edward62740/Zigbee-Tracker/README.md

# Zigbee Tracker

This is a simple RSSI-based tracking and sensor system.
