edward62740/Zigbee-Tracker/PCB Files/CC2530 Arduino Shield PCB/CC2530 Arduino Shield.png

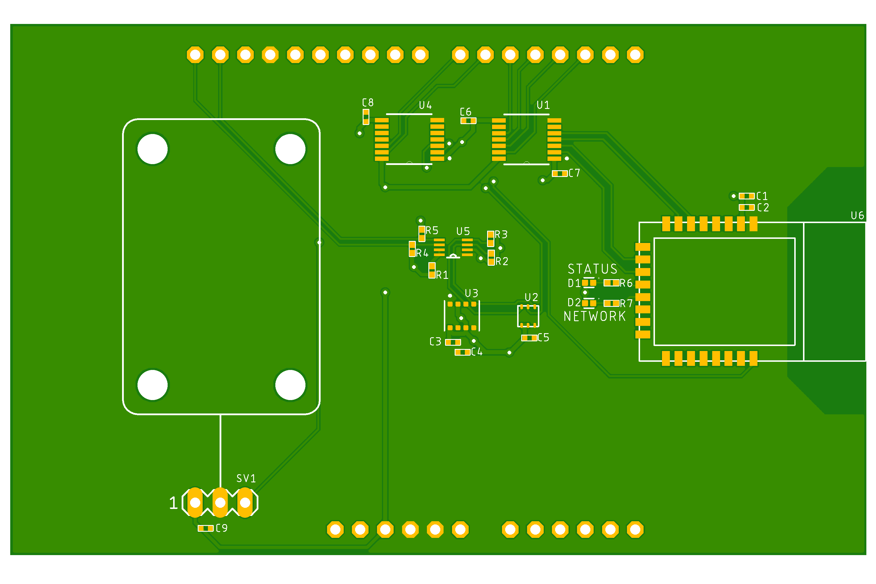
PCB Files/CC2530 Arduino Shield PCB/CC2530 Arduino Shield.png
