edward62740/Zigbee-Tracker/PCB Files/Zigbee Tracker v2.0 Debugger PCB/Zigbee Tracker v2 Debugger.brd

## EAGLE design PCB Files/Zigbee Tracker v2.0 Debugger PCB/Zigbee Tracker v2 Debugger.brd (2020-03-26)

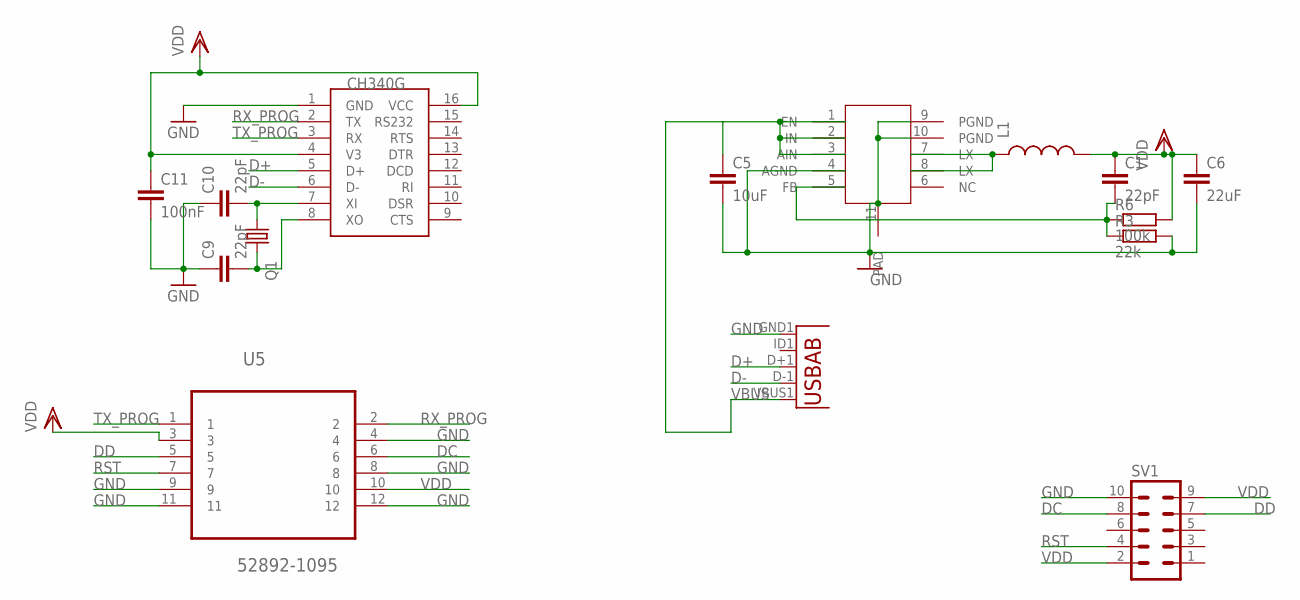
[picture p6: schematic Zigbee Tracker v2 Debugger.sch]

Parts:
C1, C9, C10: 22pF; C0402
C5: 10uF; C0402
C6: 22uF; C0402
C11: 100nF; C0402
L1: INDUCTOR; L0603
Q1: KX-7; 3.2X2.5_KX-7
R3: 22k; R0402
R6: 100k; R0402
SV1: MA05-2
U1: USB""; USB-MICRO-SMD
U5: 52892-1095; MOLEX_52892-1095
U$1: XM5152; SON50P300X300X80-11T170X240
U$2: CH340G; SOIC16

Connections:
D+: U1.D+1 (D+), U$2.5 (D+)
D-: U1.D-1 (D-), U$2.6 (D-)
DC: SV1.8, U5.6
DD: SV1.7, U5.5
GND: C5.2, C6.2, C9.1, C10.1, C11.2, R3.2, SV1.10, U1.GND1 (GND), U5.4, U5.8, U5.9, U5.11, U5.12, U$1.4 (AGND), U$1.9 (PGND), U$1.10 (PGND), U$1.11 (PAD), U$2.1 (GND)
unnamed: L1.1, U$1.7 (LX), U$1.8 (LX)
unnamed: C9.2, Q1.3 (2), U$2.8 (XO)
unnamed: C10.2, Q1.1, U$2.7 (XI)
unnamed: C1.2, R3.1, R6.1, U$1.5 (FB)
RST: SV1.4, U5.7
RX_PROG: U5.2, U$2.2 (TX)
TX_PROG: U5.1, U$2.3 (RX)
VBUS: C5.1, U1.VBUS1 (VBUS), U$1.1 (EN), U$1.2 (IN), U$1.3 (AIN)
VDD: C1.1, C6.1, C11.1, L1.2, R6.2, SV1.2, SV1.9, U5.3, U5.10, U$2.4 (V3), U$2.16 (VCC)

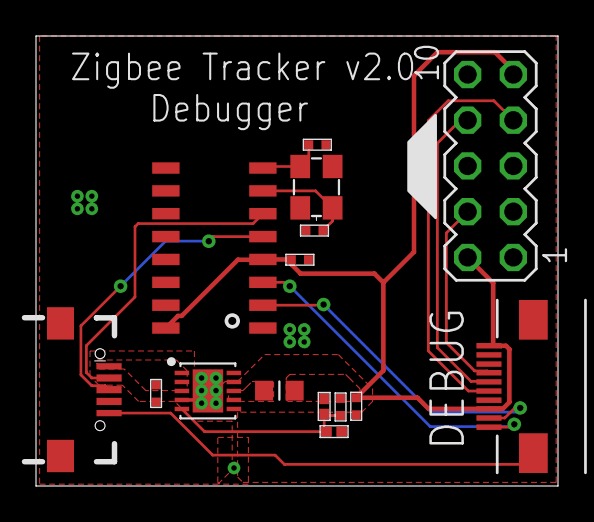
[picture p7: board Zigbee Tracker v2 Debugger.brd from above]

Board: 2 copper layers, 29.0 x 25.0 mm, 15 parts (0 on the bottom side), 14 nets.
