edward62740/Zigbee-Tracker/PCB Files/CC2530 Arduino Shield PCB/CC2530 Arduino Shield.brd

## EAGLE design PCB Files/CC2530 Arduino Shield PCB/CC2530 Arduino Shield.brd (2020-03-26)

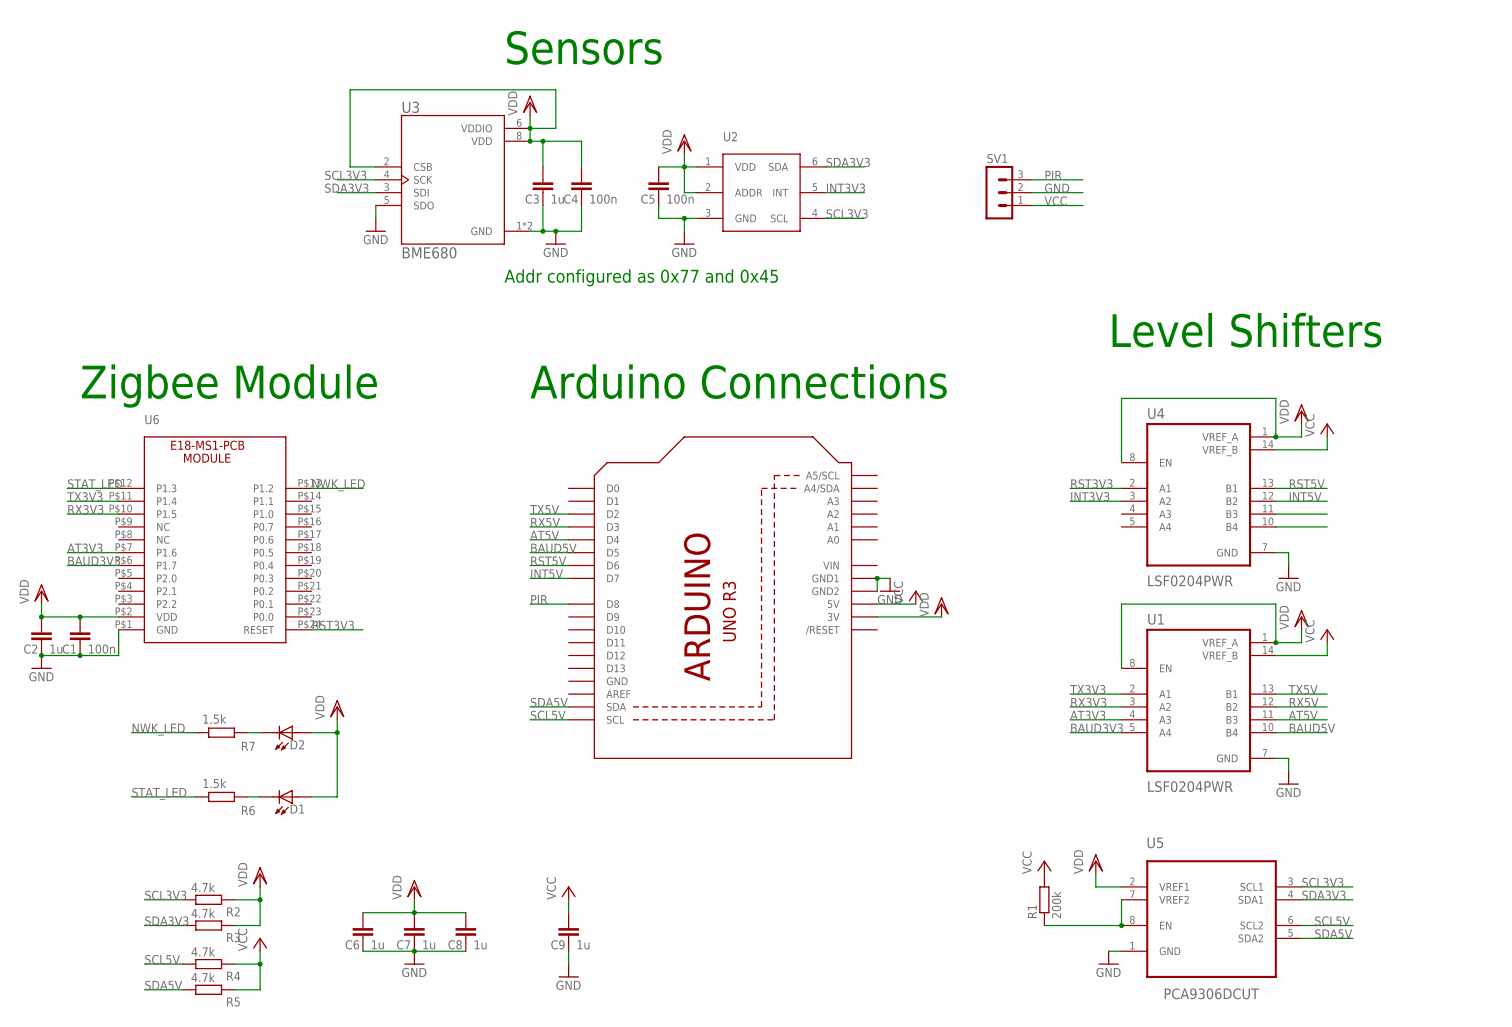
[picture p8: schematic CC2530 Arduino Shield.sch]

Parts:
C1, C4, C5: 100n; C0402
C2, C3, C6, C7, C8, C9: 1u; C0402
D1, D2: VLMG1500-GS08; LEDC1005X35N
Q1: ARDUINOR3-NOIOREF-NOTEXT; ARDUINOR3-NOTEXT-NOIOREF
R1: 200k; R0402
R2, R3, R4, R5: 4.7k; R0402
R6, R7: 1.5k; R0402
SV1: MA03-1
U1, U4: LSF0204PWR; SOP65P640X120-14N
U2: TI-OPT3001
U3: BME680; PSON80P300X300X100-8N
U5: PCA9306DCUT; SOP50P310X90-8N
U6: E18; E18-MS1-PCB

Connections:
AT3V3: U1.4 (A3), U6.P$7 (P1.6)
AT5V: Q1.D4, U1.11 (B3)
BAUD3V3: U1.5 (A4), U6.P$6 (P1.7)
BAUD5V: Q1.D5, U1.10 (B4)
GND: C1.2, C2.2, C3.2, C4.2, C5.2, C6.2, C7.2, C8.2, C9.2, Q1.GND, Q1.GND1, Q1.GND2, SV1.2, U1.7 (GND), U2.3 (GND), U3.1 (GND), U3.5 (SDO), U3.7 (GND), U4.7 (GND), U5.1 (GND), U6.P$1 (GND)
INT3V3: U2.5 (INT), U4.3 (A2)
INT5V: Q1.D7, U4.12 (B2)
unnamed: R1.1, U5.7 (VREF2), U5.8 (EN)
unnamed: D2.2, R7.2
unnamed: D1.2, R6.2
NWK_LED: R7.1, U6.P$13 (P1.2)
PIR: Q1.D8, SV1.3
RST3V3: U4.2 (A1), U6.P$24 (RESET)
RST5V: Q1.D6, U4.13 (B1)
RX3V3: U1.3 (A2), U6.P$10 (P1.5)
RX5V: Q1.D3, U1.12 (B2)
SCL3V3: R2.2, U2.4 (SCL), U3.4 (SCK), U5.3 (SCL1)
SCL5V: Q1.SCL, R4.2, U5.6 (SCL2)
SDA3V3: R3.2, U2.6 (SDA), U3.3 (SDI), U5.4 (SDA1)
SDA5V: Q1.SDA, R5.2, U5.5 (SDA2)
STAT_LED: R6.1, U6.P$12 (P1.3)
TX3V3: U1.2 (A1), U6.P$11 (P1.4)
TX5V: Q1.D2, U1.13 (B1)
VCC: C9.1, Q1.5V, R1.2, R4.1, R5.1, SV1.1, U1.14 (VREF_B), U4.14 (VREF_B)
VDD: C1.1, C2.1, C3.1, C4.1, C5.1, C6.1, C7.1, C8.1, D1.1, D2.1, Q1.3V, R2.1, R3.1, U1.1 (VREF_A), U1.8 (EN), U2.1 (VDD), U2.2 (ADDR), U3.2 (CSB), U3.6 (VDDIO), U3.8 (VDD), U4.1 (VREF_A), U4.8 (EN), U5.2 (VREF1), U6.P$2 (VDD)
VIN: Q1.VIN

Notes on the sheet:
Sensors
Zigbee Module
Arduino Connections
Level Shifters
Addr configured as 0x77 and 0x45

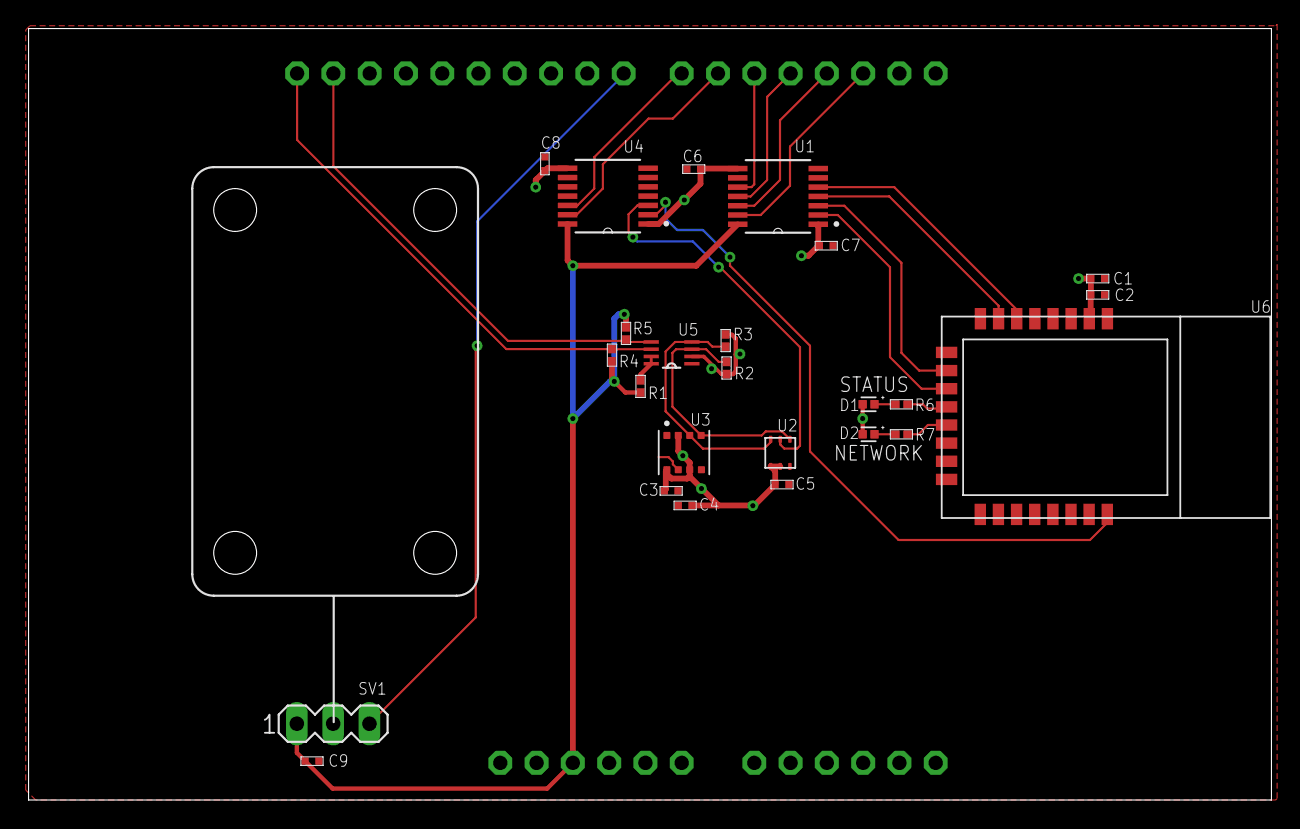
[picture p9: board CC2530 Arduino Shield.brd from above]

Board: 2 copper layers, 87.0 x 54.0 mm, 26 parts (0 on the bottom side), 25 nets.
