edward62740/Zigbee-Tracker/PCB Files/Zigbee Tracker v2.0 PCB Old/Zigbee Tracker v2.brd

## EAGLE design PCB Files/Zigbee Tracker v2.0 PCB Old/Zigbee Tracker v2.brd (2020-03-26, an earlier design)

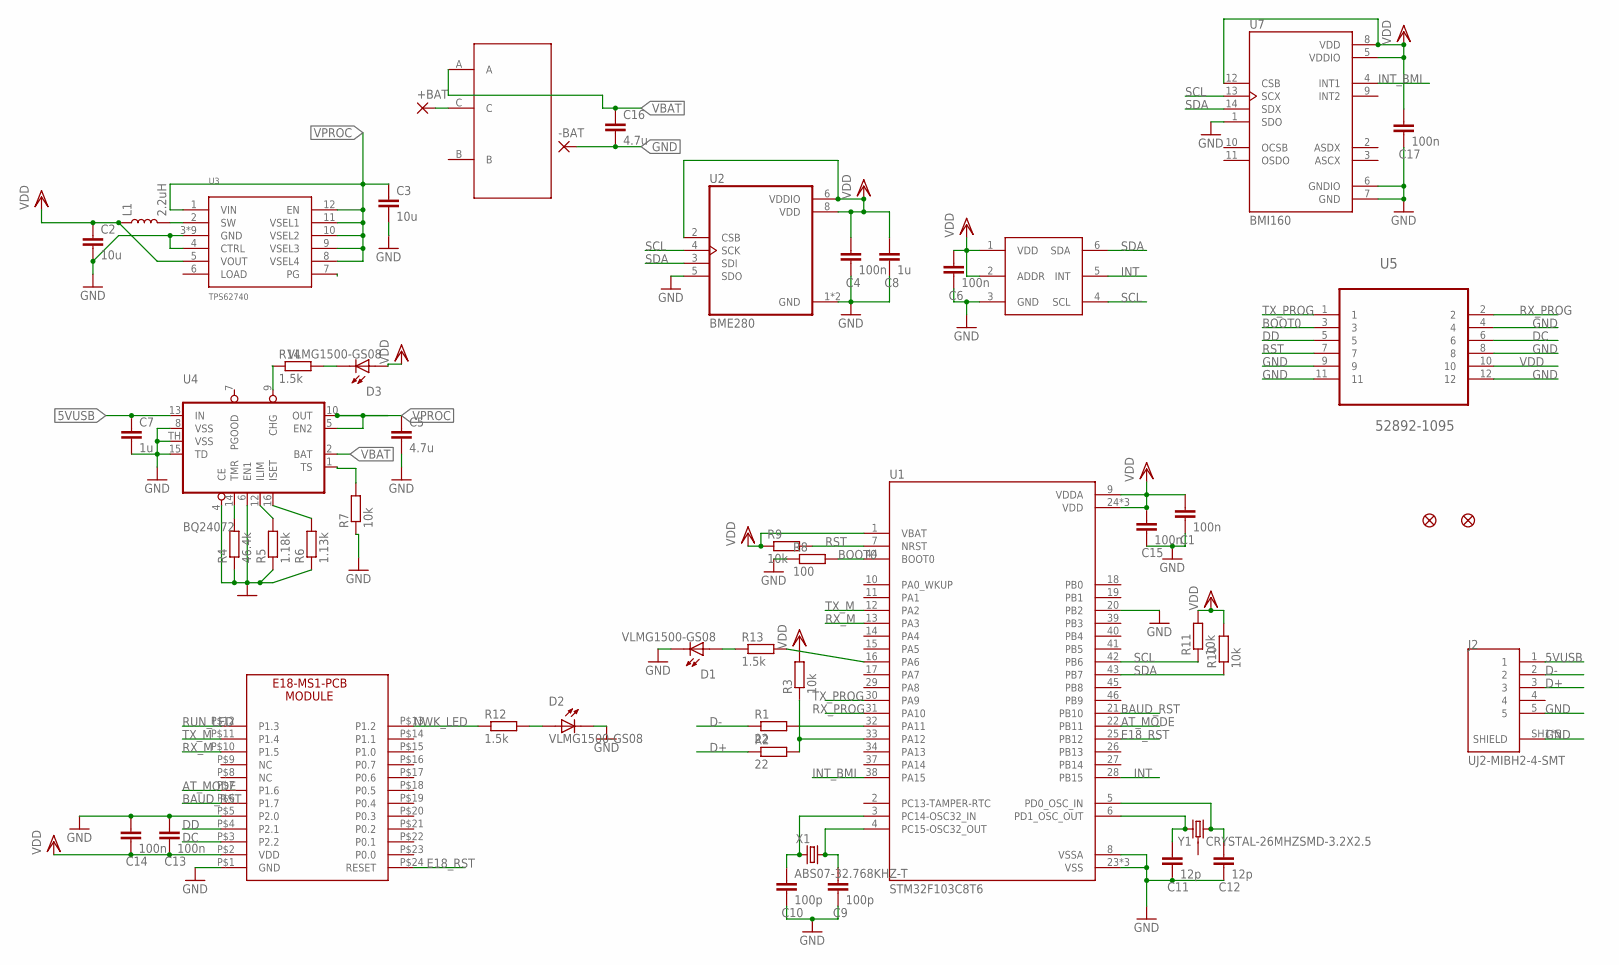
[picture p10: schematic Zigbee Tracker v2.sch]

Parts:
+BAT: 1,6/0,8
-BAT: 1,6/0,8
C1, C4, C6, C13, C14, C15, C17: 100n; C0402
C2, C3: 10u; C0402
C5, C16: 4.7u; C0402
C7, C8: 1u; C0402
C9, C10: 100p; C0402
C11, C12: 12p; C0402
D1, D2, D3: VLMG1500-GS08; LEDC1005X35N
FD1, FD2: FIDUCIALUFIDUCIAL; FIDUCIAL-MICRO
J2: UJ2-MIBH2-4-SMT; CUI_UJ2-MIBH2-4-SMT
L1: 2.2uH; 0805
R1, R2: 22; R0402
R3, R7, R9, R10, R11: 10k; R0402
R4: 46.4k; R0402
R5: 1.18k; R0402
R6: 1.13k; R0402
R8: 100; R0402
R12, R13, R14: 1.5k; R0402
U1: STM32F103C8T6; QFP50P900X900X160-48N
U2: BME280; PSON65P250X250X100-8N
U3: TPS62740; DSS
U4: BQ24072; S-PVQFN-N16
U5: 52892-1095; MOLEX_52892-1095
U7: BMI160; PQFN50P300X250X88-14N
U$1: E18; E18-MS1-PCB
U$2: TI-OPT3001
U$3: SMDTOGGLESWITCH
X1: ABS07-32.768KHZ-T
Y1: CRYSTAL-26MHZSMD-3.2X2.5; CRYSTAL-SMD-3.2X2.5MM

Connections:
5VUSB: C7.1, J2.1, U4.13 (IN)
AT_MODE: U1.22 (PB11), U$1.P$7 (P1.6)
BAUD_RST: U1.21 (PB10), U$1.P$6 (P1.7)
BOOT0: R8.2, U1.44 (BOOT0), U5.3
D+: J2.3, R2.1
D-: J2.2, R1.1
DC: U5.6, U$1.P$3 (P2.2)
DD: U5.5, U$1.P$4 (P2.1)
E18_RST: U1.25 (PB12), U$1.P$24 (RESET)
GND: -BAT.1, C1.2, C2.2, C3.2, C4.2, C5.2, C6.2, C7.2, C8.2, C9.2, C10.2, C11.2, C12.2, C13.1, C14.1, C15.2, C16.2, C17.2, D1.2, D2.2, J2.5, J2.SH1 (SHIELD), J2.SH2 (SHIELD), J2.SH3 (SHIELD), J2.SH4 (SHIELD), J2.SH5 (SHIELD), R4.1, R5.1, R6.1, R7.1, R8.1, U1.8 (VSSA), U1.20 (PB2), U1.23 (VSS), U1.35 (VSS), U1.47 (VSS), U2.1 (GND), U2.5 (SDO), U2.7 (GND), U3.3 (GND), U3.4 (CTRL), U3.13 (GND), U3.14 (GND), U3.15 (GND), U3.16 (GND), U3.18 (GND), U3.19 (GND), U3.20 (GND), U3.P$18 (GND), U4.4 (CE), U4.6 (EN1), U4.8 (VSS), U4.15 (TD), U4.TH (VSS), U5.4, U5.8, U5.9, U5.11, U5.12, U7.1 (SDO), U7.6 (GNDIO), U7.7 (GND), U$1.P$1 (GND), U$1.P$5 (P2.0), U$2.3 (GND)
INT: U1.28 (PB15), U$2.5 (INT)
INT_BMI: U1.38 (PA15), U7.4 (INT1)
unnamed: R1.2, U1.32 (PA11)
unnamed: R2.2, R3.1, U1.33 (PA12)
unnamed: C10.1, U1.3 (PC14-OSC32_IN), X1.1
unnamed: C9.1, U1.4 (PC15-OSC32_OUT), X1.2
unnamed: C12.1, U1.5 (PD0_OSC_IN), Y1.3 (2)
unnamed: L1.2, U3.2 (SW)
unnamed: C11.1, U1.6 (PD1_OSC_OUT), Y1.1
unnamed: R4.2, U4.14 (TMR)
unnamed: R5.2, U4.12 (ILIM)
unnamed: +BAT.1, U$3.C
unnamed: D2.1, R12.2
unnamed: R6.2, U4.16 (ISET)
unnamed: R13.2, U1.16 (PA6)
unnamed: D1.1, R13.1
unnamed: D3.2, R14.2
unnamed: R14.1, U4.9 (CHG)
NWK_LED: R12.1, U$1.P$13 (P1.2)
PG_SMR: U3.7 (PG)
RST: R9.2, U1.7 (NRST), U5.7
RUN_LED: U$1.P$12 (P1.3)
RX_M: U1.13 (PA3), U$1.P$10 (P1.5)
RX_PROG: U1.31 (PA10), U5.2
SCL: R11.1, U1.42 (PB6), U2.4 (SCK), U7.13 (SCX), U$2.4 (SCL)
SDA: R10.1, U1.43 (PB7), U2.3 (SDI), U7.14 (SDX), U$2.6 (SDA)
TS: R7.2, U4.1 (TS)
TX_M: U1.12 (PA2), U$1.P$11 (P1.4)
TX_PROG: U1.30 (PA9), U5.1
VBAT: C16.1, U4.2 (BAT), U$3.A
VDD: C1.1, C2.1, C4.1, C6.1, C8.1, C13.2, C14.2, C15.1, C17.1, D3.1, L1.1, R3.2, R9.1, R10.2, R11.2, U1.1 (VBAT), U1.9 (VDDA), U1.24 (VDD), U1.36 (VDD), U1.48 (VDD), U2.2 (CSB), U2.6 (VDDIO), U2.8 (VDD), U3.5 (VOUT), U5.10, U7.5 (VDDIO), U7.8 (VDD), U7.12 (CSB), U$1.P$2 (VDD), U$2.1 (VDD), U$2.2 (ADDR)
VPROC: C3.1, C5.1, U3.1 (VIN), U3.8 (VSEL4), U3.9 (VSEL3), U3.10 (VSEL2), U3.11 (VSEL1), U3.12 (EN), U4.5 (EN2), U4.10 (OUT)

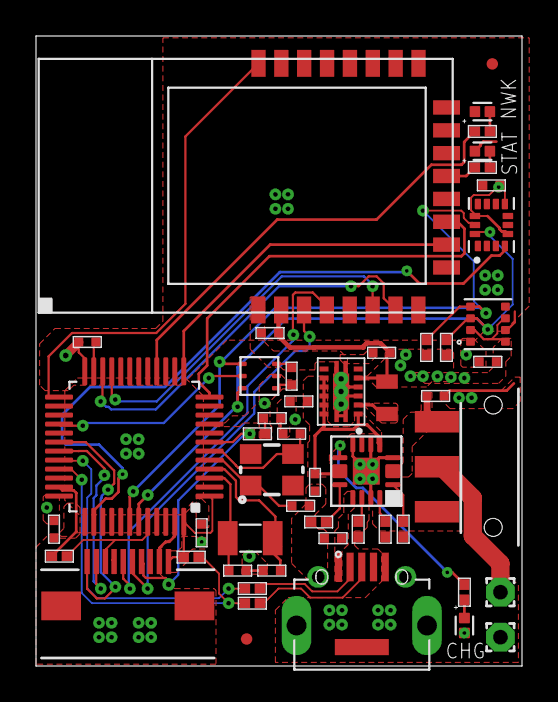
[picture p11: board Zigbee Tracker v2.brd from above]

Board: 4 copper layers, 27.0 x 35.0 mm, 51 parts (0 on the bottom side), 40 nets.
