edward62740/Zigbee-Tracker/PCB Files/Zigbee Tracker v2.0 Coordinator PCB/Zigbee Tracker v2 Mainboard.brd

## EAGLE design PCB Files/Zigbee Tracker v2.0 Coordinator PCB/Zigbee Tracker v2 Mainboard.brd (2020-03-26)

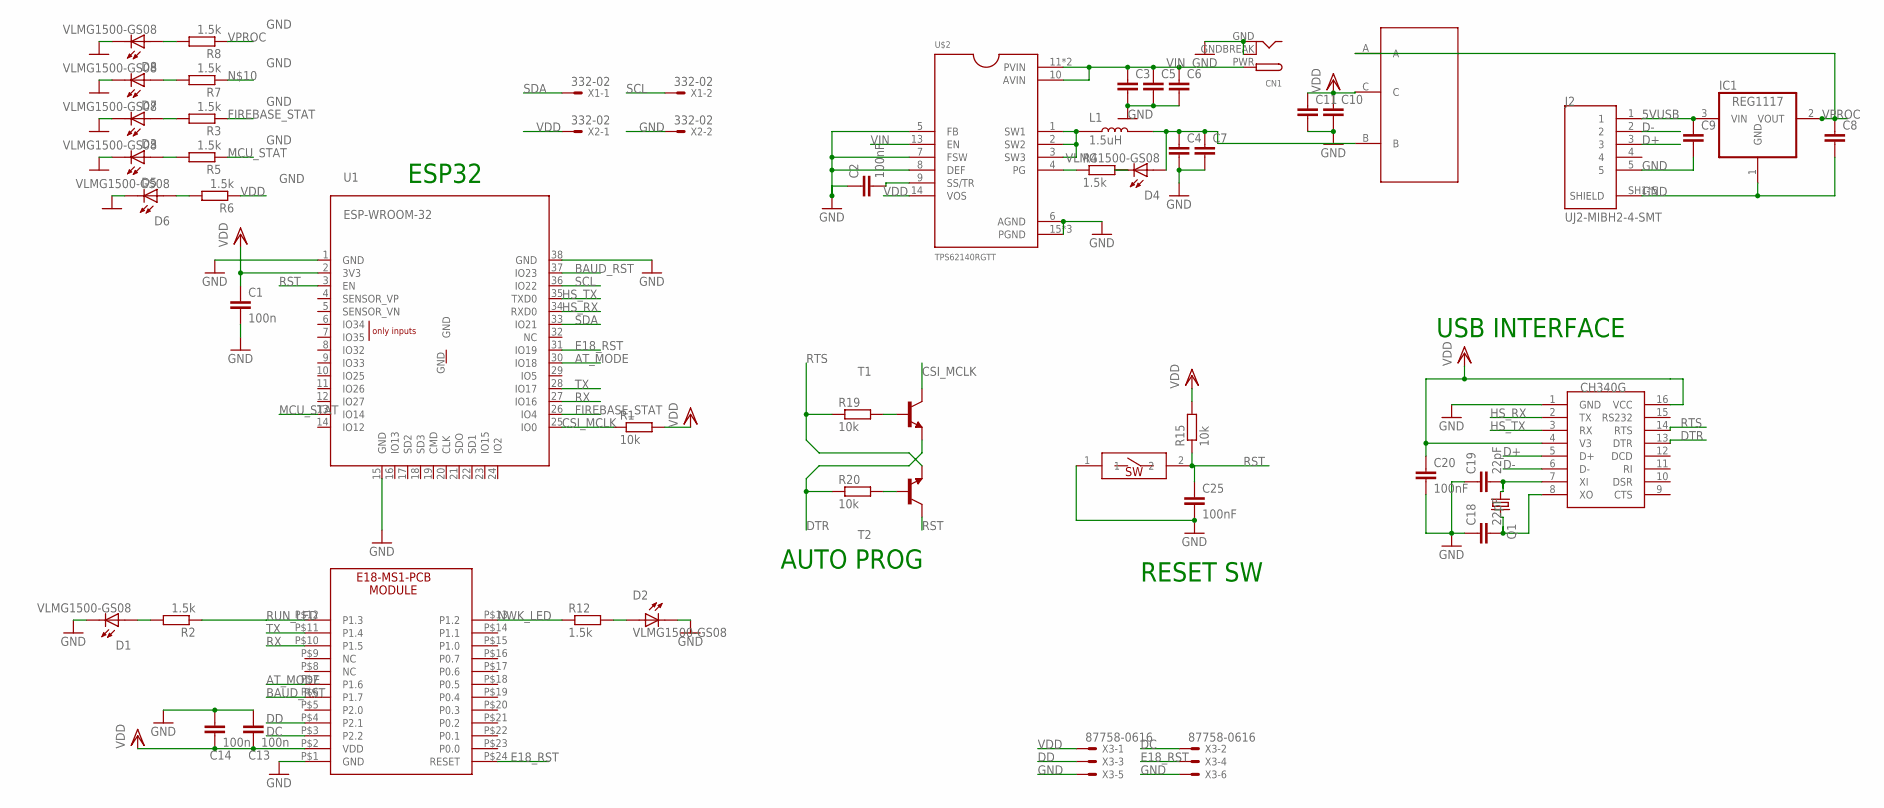
[picture p12: schematic Zigbee Tracker v2 Mainboard.sch]

Parts:
C1, C13, C14: 100n; C0603
C2, C25: 100nF; C0402
C3, C4: CC0402; C0402
C5, C6, C7, C10, C11: CC1210; C1210
C8, C9: CC0603; C0603
C18, C19: 22pF; C0402
C20: 100nF; C0603
CN1: DCBARRELPTH; DCJACK_2MM_PTH
D1, D2, D3, D4, D5, D6, D7, D8: VLMG1500-GS08; LEDC1005X35N
IC1: REG1117; SOT223
J2: UJ2-MIBH2-4-SMT; CUI_UJ2-MIBH2-4-SMT
L1: 1.5uH; INDC2520X120N
Q1: KX-7; 3.2X2.5_KX-7
R1, R15, R19, R20: 10k; R0402
R2, R3, R4, R5, R6, R7, R8, R12: 1.5k; R0402
RESET: SMDSWITCH; RESC4217X170
T1, T2: -NPN-SOT23-BEC; SOT23-BEC
U1: ESP-WROOM-32
U5: H; SOIC16
U$1: E18; E18-MS1-PCB
U$2: TPS62140RGTT; QFN50P300X300X100-17N
U$3: SMDTOGGLESWITCH
X1, X2: 332-02
X3: 87758-0616

Connections:
5VUSB: C9.1, IC1.3 (VIN), J2.1
AT_MODE: U1.30 (IO18), U$1.P$7 (P1.6)
BAUD_RST: U1.37 (IO23), U$1.P$6 (P1.7)
CSI_MCLK: R1.1, T1.C, U1.25 (IO0)
D+: J2.3, U5.5 (D+)
D-: J2.2, U5.6 (D-)
DC: U$1.P$3 (P2.2), X3.2
DD: U$1.P$4 (P2.1), X3.3
DTR: R20.1, T1.E, U5.13 (DTR)
E18_RST: U1.31 (IO19), U$1.P$24 (RESET), X3.4
FIREBASE_STAT: R3.1, U1.26 (IO4)
GND: C1.2, C2.1, C3.2, C4.2, C5.2, C6.2, C7.2, C8.2, C9.2, C10.2, C11.2, C13.1, C14.1, C18.1, C19.1, C20.2, C25.2, CN1.GND, CN1.GNDBREAK, D1.2, D2.2, D3.2, D5.2, D6.2, D7.2, D8.2, IC1.1 (GND), J2.5, J2.SH1 (SHIELD), J2.SH2 (SHIELD), J2.SH3 (SHIELD), J2.SH4 (SHIELD), J2.SH5 (SHIELD), RESET.1, U1.1 (GND), U1.15 (GND), U1.38 (GND), U5.1 (GND), U$1.P$1 (GND), U$2.5 (FB), U$2.6 (AGND), U$2.7 (FSW), U$2.8 (DEF), U$2.15 (PGND), U$2.16 (PGND), U$2.TH (PGND), X2.2, X3.5, X3.6
HS_RX: U1.34 (RXD0), U5.2 (TX)
HS_TX: U1.35 (TXD0), U5.3 (RX)
MCU_STAT: R5.1, U1.13 (IO14)
unnamed: L1.1, U$2.1 (SW1), U$2.2 (SW2), U$2.3 (SW3)
unnamed: C2.2, U$2.9 (SS/TR)
unnamed: R19.2, T1.B
unnamed: D1.1, R2.2
unnamed: C18.2, Q1.3 (2), U5.8 (XO)
unnamed: R20.2, T2.B
unnamed: D3.1, R3.2
unnamed: D4.2, R4.2
unnamed: C19.2, Q1.1, U5.7 (XI)
unnamed: C4.1, C7.1, D4.1, L1.2, R7.1, U$3.B
unnamed: D2.1, R12.2
unnamed: R4.1, U$2.4 (PG)
unnamed: D5.1, R5.2
unnamed: D6.1, R6.2
unnamed: D7.1, R7.2
unnamed: D8.1, R8.2
NWK_LED: R12.1, U$1.P$13 (P1.2)
RST: C25.1, R15.1, RESET.2, T2.C, U1.3 (EN)
RTS: R19.1, T2.E, U5.14 (RTS)
RUN_LED: R2.1, U$1.P$12 (P1.3)
RX: U1.27 (IO16), U$1.P$10 (P1.5)
SCL: U1.36 (IO22), X1.2
SDA: U1.33 (IO21), X1.1
TX: U1.28 (IO17), U$1.P$11 (P1.4)
VDD: C1.1, C10.1, C11.1, C13.2, C14.2, C20.1, R1.2, R6.1, R15.2, U1.2 (3V3), U5.4 (V3), U5.16 (VCC), U$1.P$2 (VDD), U$2.14 (VOS), U$3.C, X2.1, X3.1
VIN: C3.1, C5.1, C6.1, CN1.PWR, U$2.10 (AVIN), U$2.11 (PVIN), U$2.12 (PVIN), U$2.13 (EN)
VPROC: C8.1, IC1.2 (VOUT), R8.1, U$3.A

Notes on the sheet:
RESET SW
AUTO PROG
ESP32
USB INTERFACE

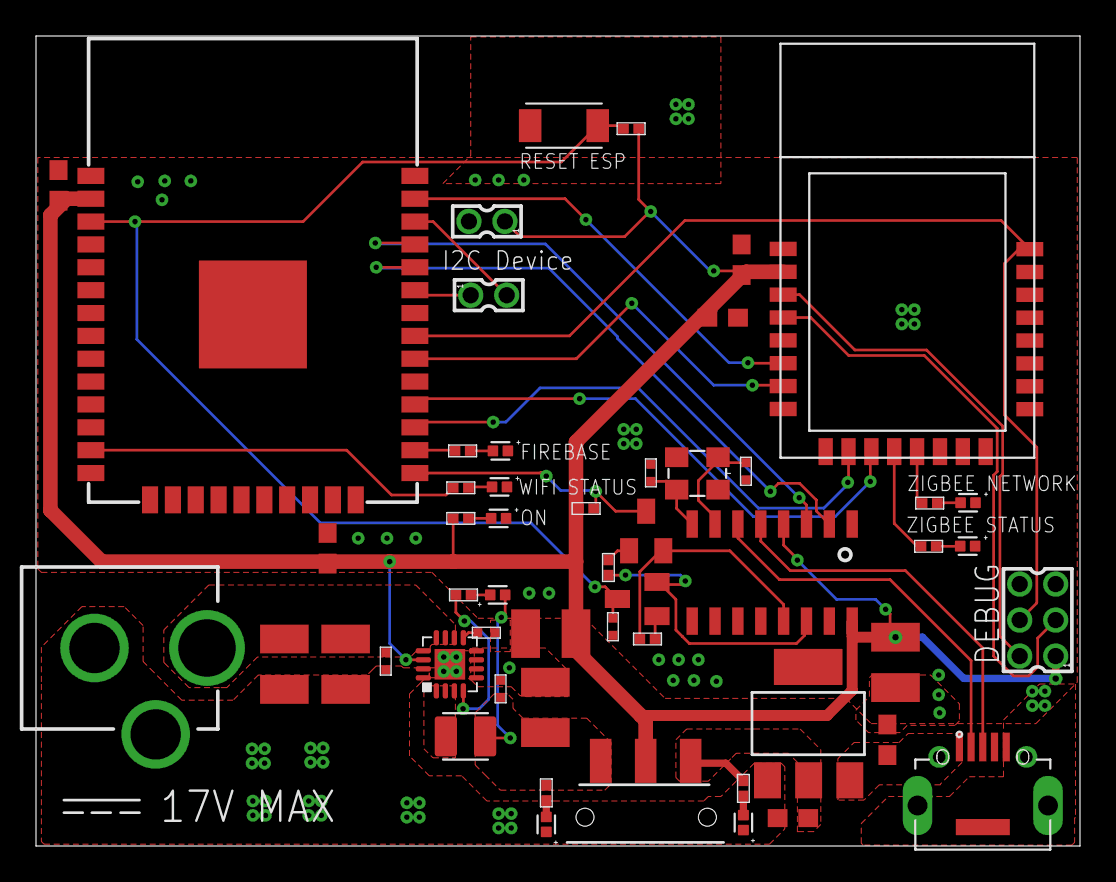
[picture p13: board Zigbee Tracker v2 Mainboard.brd from above]

Board: 2 copper layers, 58.0 x 45.0 mm, 53 parts (0 on the bottom side), 42 nets.
