edward62740/Zigbee-Tracker/(notices)

Notices in the files:
parts and their libraries:
crystal-geyer_V1_0: Copyright: Geyer-Electronic
FaBo-Mems: Released under the Creative Commons Attribution-ShareAlike 4.0 License
https://creativecommons.org/licenses/by-sa/4.0
SparkFun-Coils: Licensing: Creative Commons ShareAlike 4.0 International - https://creativecommons.org/licenses/by-sa/4.0
